atx/gps-freq-counter/README.md

# gps-freq-counter
Frequency counter using a GPS receiver PPS output as its reference

schema
