atx/gps-freq-counter/mech/box.stl

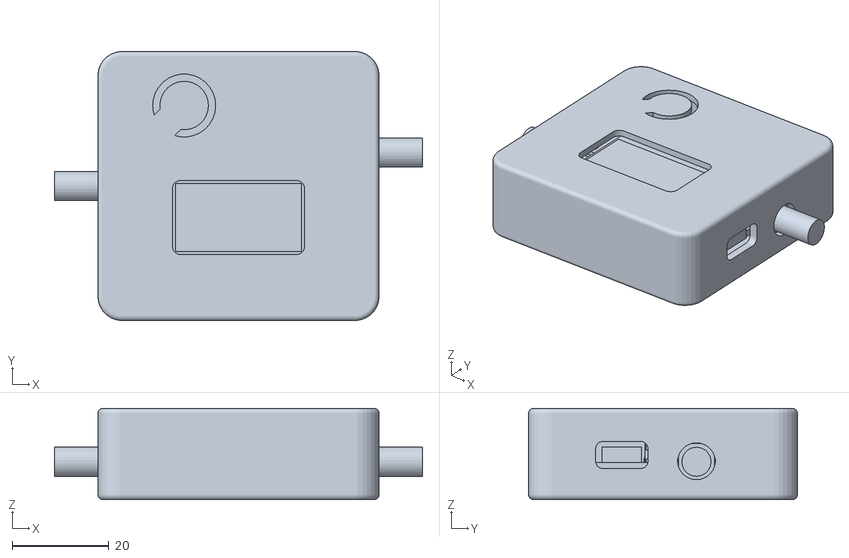
[picture p1: CAD file, 2018-04-28]
mech/box.stl
75.9 x 55.4 x 18.8
