atx/gps-freq-counter/(threads)

Thread 1 (2018-07-31):

Wishlist for v1.1

atx, 2018-07-31:
* [ ] Easier to solder ESD protection for the USB port
 * [ ] Proper test points
 * [ ] Better input processing for weak inputs (comparator?)
 * [ ] More capacitors for the FPGA
 * [ ] Correct footprint for the oscillator
 * [ ] Maybe switch to LEA-6T or NEO-8M?
