atx/gps-freq-counter/pcb/gfc.kicad_pcb

## KiCad design pcb/gfc.kicad_pcb (2018-03-02)

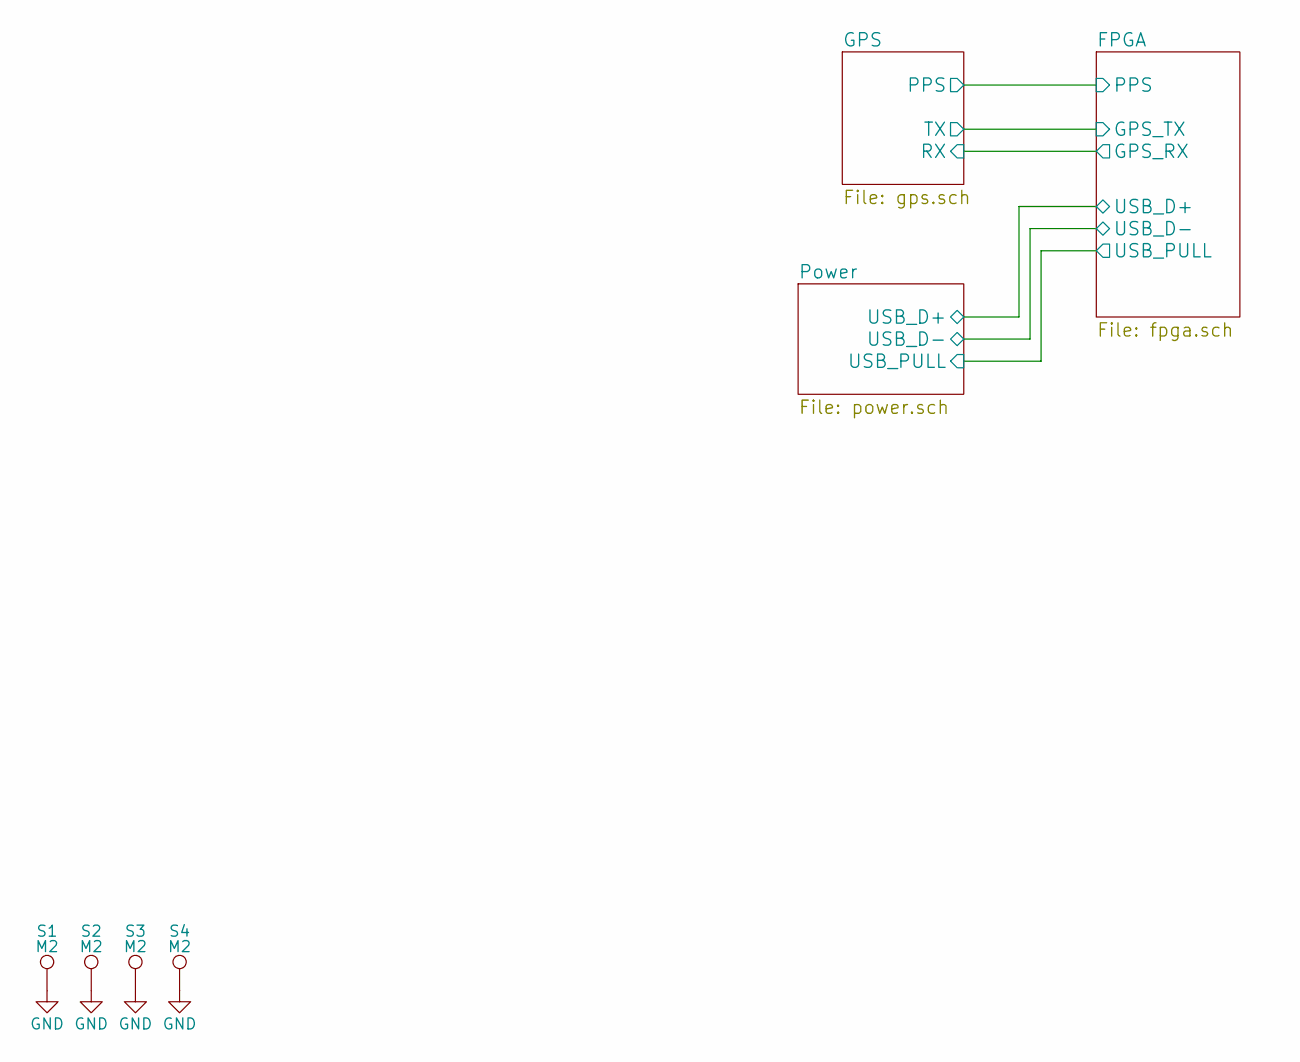
[picture p2: schematic gfc.sch]

Parts:
S1, S2, S3, S4: M2; MountingHole_2.2mm_M2_Pad

Connections:
GND: S1.1, S2.1, S3.1, S4.1; also elsewhere on the board

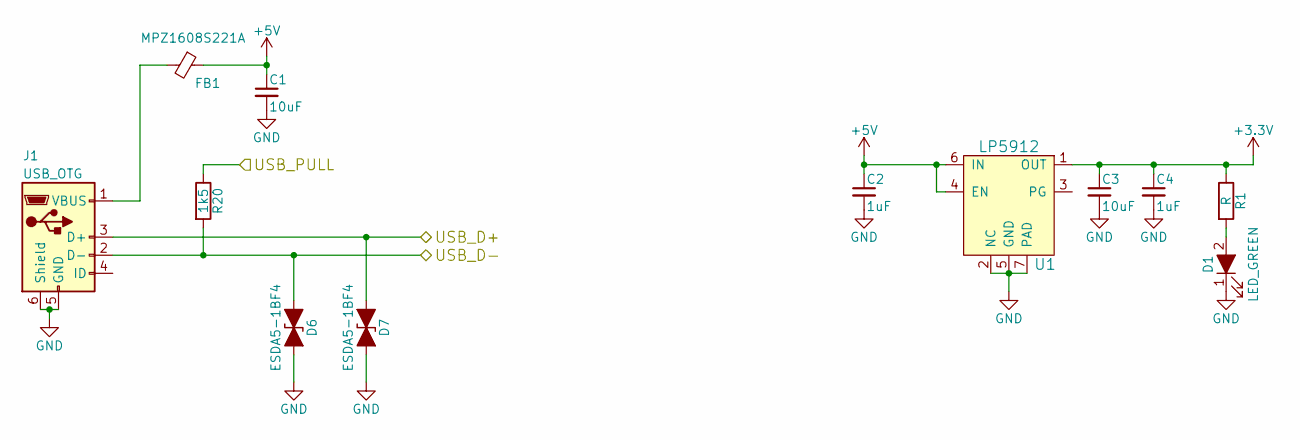
[picture p3: schematic power.sch]

Parts:
C1, C3: 10uF; C_0603
C2, C4: 1uF; C_0402
D1: LED_GREEN; LED_0603
D6, D7: ESDA5-1BF4; D_0603
FB1: MPZ1608S221A; L_0603
J1: USB_OTG; USB_Micro-B
R1: R; R_0402
R20: 1k5; R_0402
U1: LP5912; WSON-6-DRV

Connections:
+3V3: C3.1, C4.1, R1.1, U1.1 (OUT); also elsewhere on the board
+5V: C1.1, C2.1, FB1.1, U1.4 (EN), U1.6 (IN)
/FPGA/USB_D+: D7.1 (A1), J1.3 (D+); also elsewhere on the board
/FPGA/USB_D-: D6.1 (A1), J1.2 (D-), R20.2; also elsewhere on the board
/FPGA/USB_PULL: R20.1; also elsewhere on the board
GND: C1.2, C2.2, C3.2, C4.2, D1.1 (K), D6.2 (A2), D7.2 (A2), J1.5 (GND), J1.6 (Shield), U1.2 (NC), U1.5 (GND), U1.7 (PAD); also elsewhere on the board
unnamed: D1.2 (A), R1.2
unnamed: FB1.2, J1.1 (VBUS)

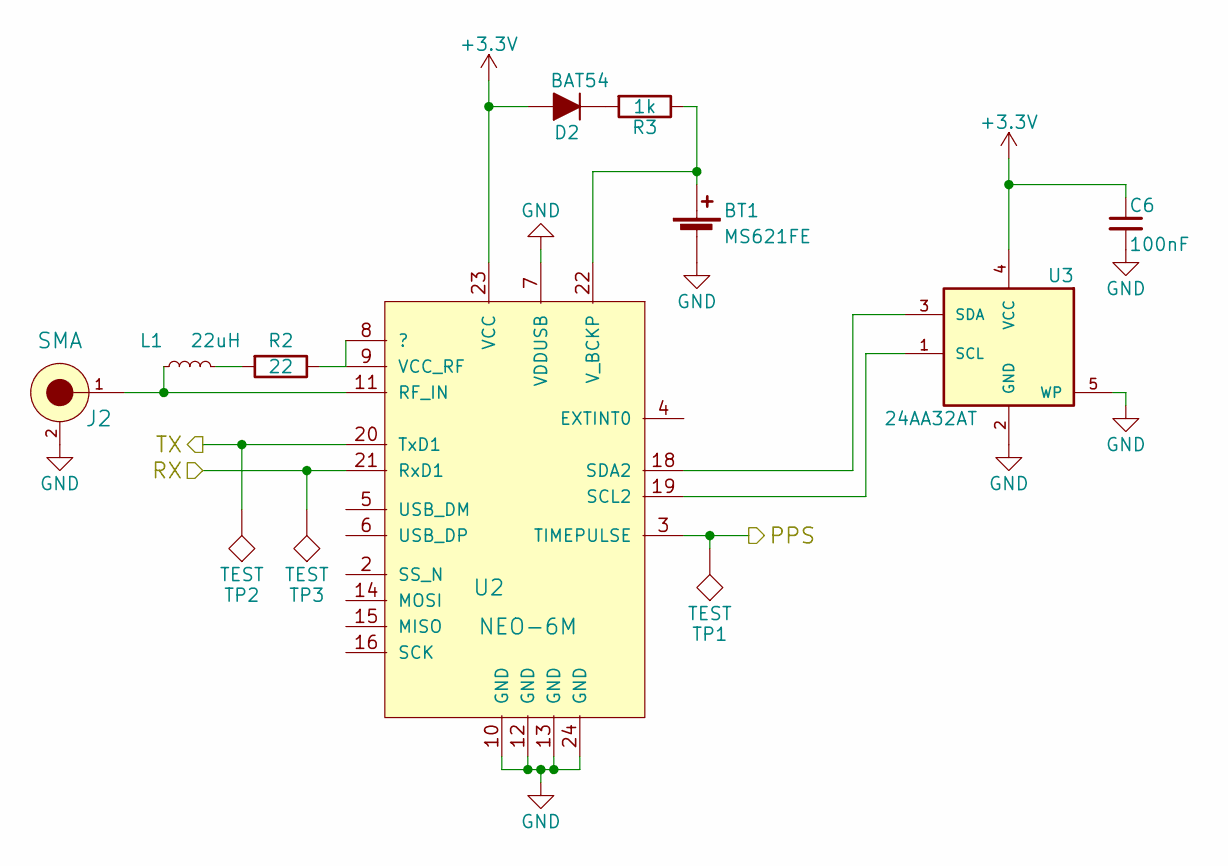
[picture p4: schematic gps.sch]

Parts:
BT1: MS621FE
C6: 100nF; C_0402
D2: BAT54; D_SOT-23_ANK
J2: SMA; CON-SMA-EDGE
L1: 22uH; L_0805
R2: 22; R_0402
R3: 1k; R_0402
TP1, TP2, TP3: TEST; PINTST
U2: NEO-6M; NEO-6
U3: 24AA32AT; SOT-23-5

Connections:
+3V3: C6.1, D2.2 (A), U2.23 (VCC), U3.4 (VCC); also elsewhere on the board
/FPGA/GPS_RX: TP3.1, U2.21 (RxD1); also elsewhere on the board
/FPGA/GPS_TX: TP2.1, U2.20 (TxD1); also elsewhere on the board
/FPGA/PPS: TP1.1, U2.3 (TIMEPULSE); also elsewhere on the board
GND: BT1.2 (-), C6.2, J2.2, J2.3, J2.4, J2.5, U2.7 (VDDUSB), U2.10 (GND), U2.12 (GND), U2.13 (GND), U2.24 (GND), U3.2 (GND), U3.5 (WP); also elsewhere on the board
unnamed: BT1.1 (+), R3.1, U2.22 (V_BCKP)
unnamed: D2.1 (K), R3.2
unnamed: J2.1, L1.1, U2.11 (RF_IN)
unnamed: L1.2, R2.2
unnamed: R2.1, U2.8 (?), U2.9 (VCC_RF)
unnamed: U2.18 (SDA2), U3.3 (SDA)
unnamed: U2.19 (SCL2), U3.1 (SCL)

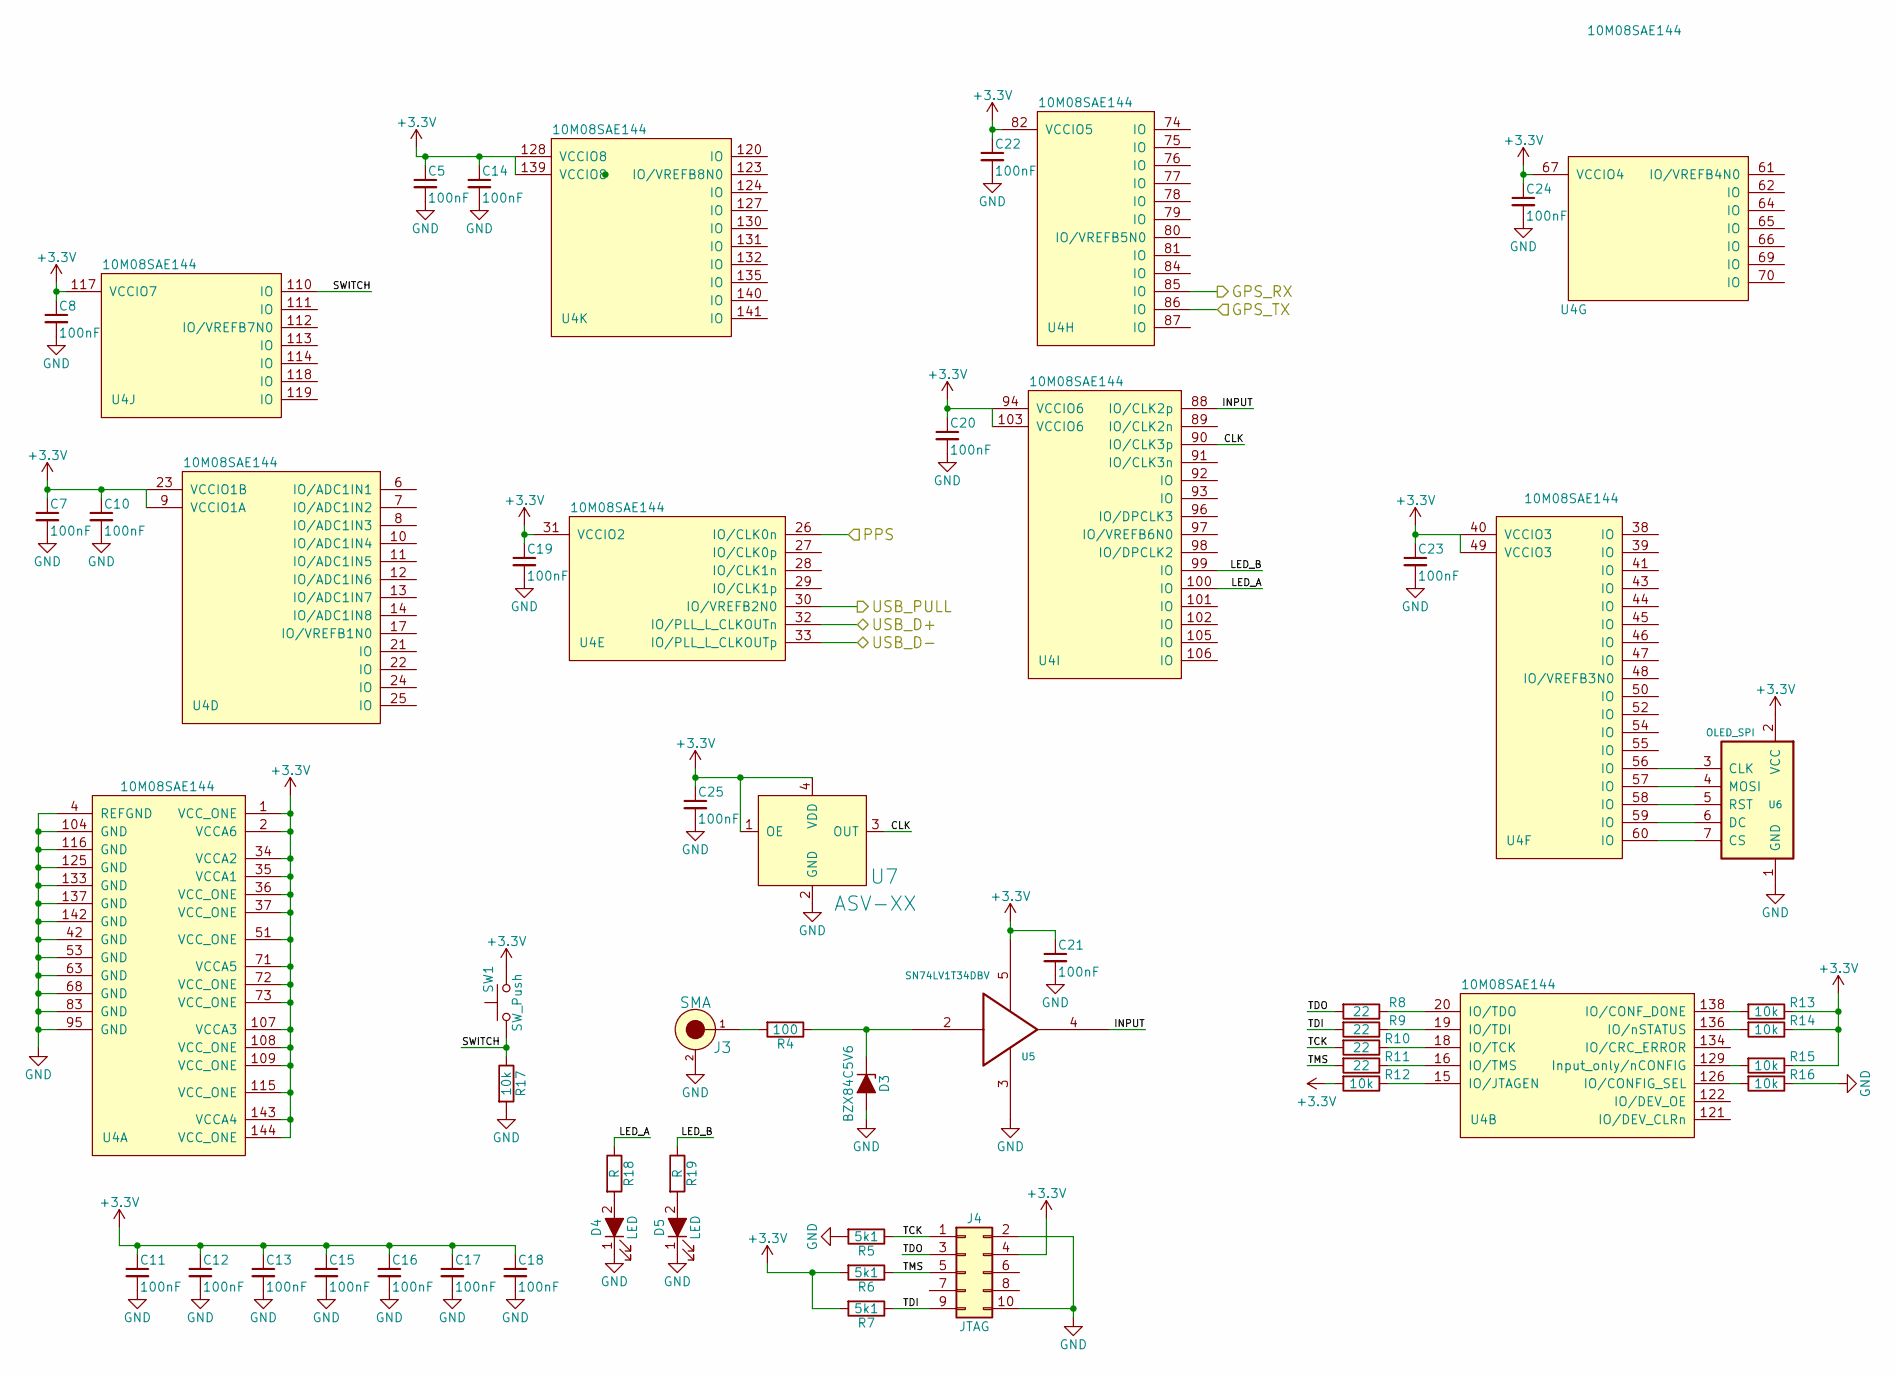
[picture p5: schematic fpga.sch]

Parts:
C5, C7, C8, C10, C11, C12, C13, C14, C15, C16, C17, C18, C19, C20, C21, C22, C23, C24, C25: 100nF; C_0402
D3: BZX84C5V6; D_SOT-23_ANK
D4, D5: LED; LED_0603
J3: SMA; CON-SMA-EDGE
J4: JTAG; Pin_Header_Straight_2x05_Pitch2.54mm_SMD
R4: 100; R_0402
R5, R6, R7: 5k1; R_0402
R8, R9, R10, R11: 22; R_0402
R12, R13, R14, R15, R16, R17: 10k; R_0402
R18, R19: R; R_0402
SW1: SW_Push; SW_PUSH_6mm_h13mm
U4: 10M08SAE144; TQFP-144_20x20mm_Pitch0.5mm
U5: SN74LV1T34DBV; SOT-23-5
U6: OLED_SPI
U7: ASV-XX

Connections:
+3V3: C5.1, C7.1, C8.1, C10.1, C11.1, C12.1, C13.1, C14.1, C15.1, C16.1, C17.1, C18.1, C19.1, C20.1, C21.1, C22.1, C23.1, C24.1, C25.1, J4.4, R6.2, R7.2, R12.2, R13.1, R14.1, R15.1, SW1.2, U4.1 (VCC_ONE), U4.2 (VCCA6), U4.9 (VCCIO1A), U4.23 (VCCIO1B), U4.31 (VCCIO2), U4.34 (VCCA2), U4.35 (VCCA1), U4.36 (VCC_ONE), U4.37 (VCC_ONE), U4.40 (VCCIO3), U4.49 (VCCIO3), U4.51 (VCC_ONE), U4.67 (VCCIO4), U4.71 (VCCA5), U4.72 (VCC_ONE), U4.73 (VCC_ONE), U4.82 (VCCIO5), U4.94 (VCCIO6), U4.103 (VCCIO6), U4.107 (VCCA3), U4.108 (VCC_ONE), U4.109 (VCC_ONE), U4.115 (VCC_ONE), U4.117 (VCCIO7), U4.128 (VCCIO8), U4.139 (VCCIO8), U4.143 (VCCA4), U4.144 (VCC_ONE), U5.5, U6.2 (VCC), U7.1 (OE), U7.4 (VDD); also elsewhere on the board
/FPGA/CLK: U4.90 (IO/CLK3p), U7.3 (OUT)
/FPGA/GPS_RX: U4.85 (IO); also elsewhere on the board
/FPGA/GPS_TX: U4.86 (IO); also elsewhere on the board
/FPGA/INPUT: U4.88 (IO/CLK2p), U5.4
/FPGA/LED_A: R18.1, U4.100 (IO)
/FPGA/LED_B: R19.1, U4.99 (IO)
/FPGA/PPS: U4.26 (IO/CLK0n); also elsewhere on the board
/FPGA/SWITCH: R17.1, SW1.1, U4.110 (IO)
/FPGA/TCK: J4.1, R5.1, R10.2
/FPGA/TDI: J4.9, R7.1, R9.2
/FPGA/TDO: J4.3, R8.2
/FPGA/TMS: J4.5, R6.1, R11.2
/FPGA/USB_D+: U4.32 (IO/PLL_L_CLKOUTn); also elsewhere on the board
/FPGA/USB_D-: U4.33 (IO/PLL_L_CLKOUTp); also elsewhere on the board
/FPGA/USB_PULL: U4.30 (IO/VREFB2N0); also elsewhere on the board
GND: C5.2, C7.2, C8.2, C10.2, C11.2, C12.2, C13.2, C14.2, C15.2, C16.2, C17.2, C18.2, C19.2, C20.2, C21.2, C22.2, C23.2, C24.2, C25.2, D3.2 (A), D4.1 (K), D5.1 (K), J3.2, J3.3, J3.4, J3.5, J4.2, J4.10, R5.2, R16.1, R17.2, U4.4 (REFGND), U4.42 (GND), U4.53 (GND), U4.63 (GND), U4.68 (GND), U4.83 (GND), U4.95 (GND), U4.104 (GND), U4.116 (GND), U4.125 (GND), U4.133 (GND), U4.137 (GND), U4.142 (GND), U5.3, U6.1 (GND), U7.2 (GND); also elsewhere on the board
unnamed: D3.1 (K), R4.1, U5.2
unnamed: D4.2 (A), R18.2
unnamed: D5.2 (A), R19.2
unnamed: J3.1, R4.2
unnamed: R8.1, U4.20 (IO/TDO)
unnamed: R9.1, U4.19 (IO/TDI)
unnamed: R10.1, U4.18 (IO/TCK)
unnamed: R11.1, U4.16 (IO/TMS)
unnamed: R12.1, U4.15 (IO/JTAGEN)
unnamed: R13.2, U4.138 (IO/CONF_DONE)
unnamed: R14.2, U4.136 (IO/nSTATUS)
unnamed: R15.2, U4.129 (Input_only/nCONFIG)
unnamed: R16.2, U4.126 (IO/CONFIG_SEL)
unnamed: U4.56 (IO), U6.3 (CLK)
unnamed: U4.57 (IO), U6.4 (MOSI)
unnamed: U4.58 (IO), U6.5 (RST)
unnamed: U4.59 (IO), U6.6 (DC)
unnamed: U4.60 (IO), U6.7 (CS)

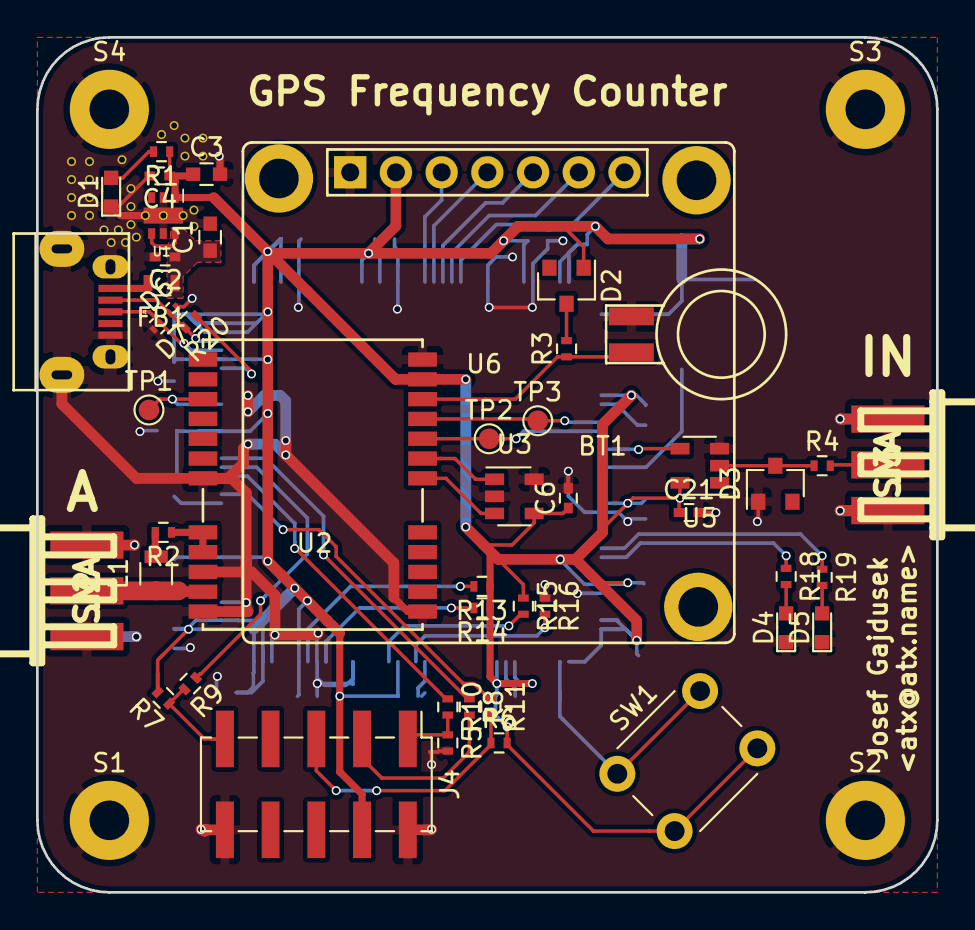
[picture p6: board gfc.kicad_pcb from above]

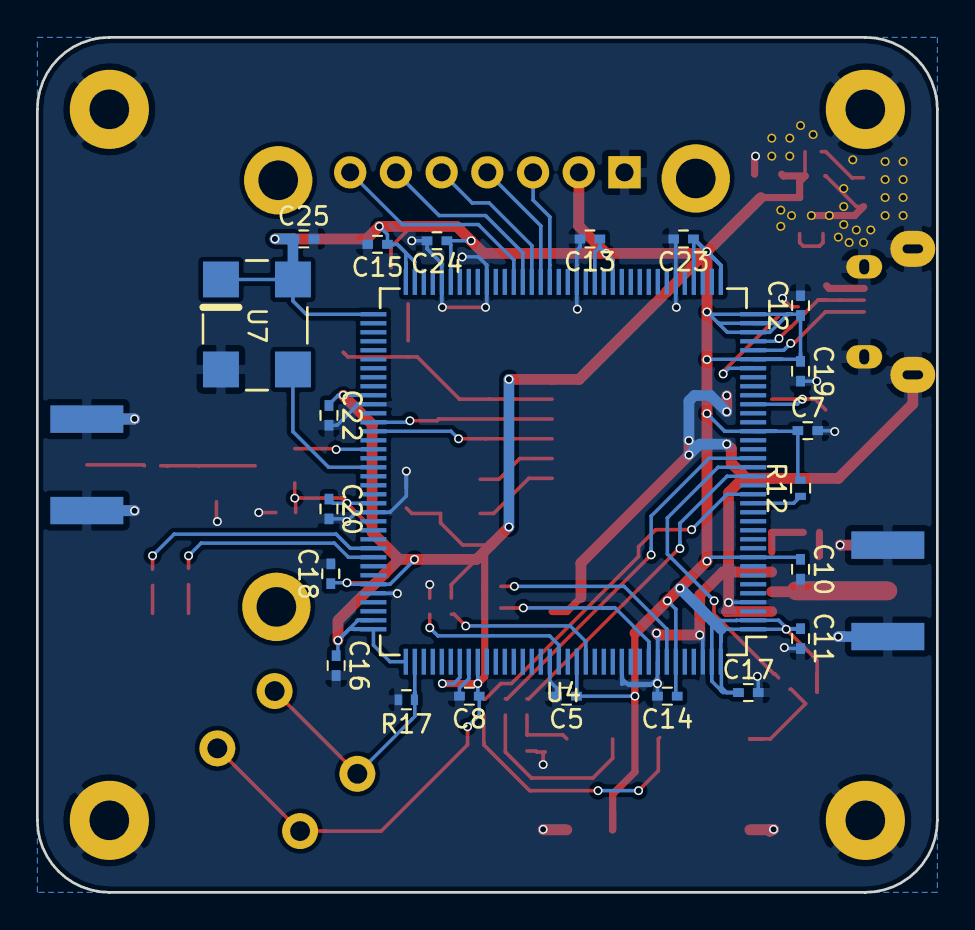
[picture p7: board gfc.kicad_pcb from below]

Board: 2 copper layers, 50.0 x 47.5 mm, 73 parts (22 on the bottom side), 45 nets.
