atx/gps-freq-counter/(commit log)

2018-03-02 pcb: Add the PCB
    [fpga.sch, gfc.kicad_pcb, gfc.sch, gps.sch, power.sch]
2018-03-09 fpga: Add SPI module
2018-03-23 fpga: Improve SPI tests
2018-03-23 fpga/src: Add SPI integration test
2018-03-24 fpga: Add UART transceiver implementation
2018-03-29 fpga: Group SPI signals in SPIBundle
2018-03-29 fpga: PicoRVTests: Switch to the Verilog-based memory implementation
2018-03-29 fpga: SPI: Tie the CS pin to the SPI peripheral
2018-03-31 fpga: Fix the PLL
    Turns out that 100nF for each pin group isn't really sufficient decoupling
2018-03-31 fpga: MemoryMux: Switch to Mux1H
    This is unsurprisingly much faster and smaller
2018-04-01 fpga: Add millisecond timer register
2018-04-01 fpga: SPI: Allow only single ported reads
2018-04-01 fpga: SPI: Fix write not being performed in some circumstances
2018-04-01 fpga: UART: Externalize the status flags
2018-04-08 mech: First version of the enclosure
    To be printed
    [box.scad, box.stl]
2018-04-12 fpga: Switch to using MIF files for the Quartus toolchain
    Faster firmware reloading this way
2018-04-12 fpga: UARTTests: Minor improvement
2018-04-12 Switch to the UBX binary protocol for the GPS module
2018-04-28 mech: Box update
    [box.scad, box.stl]
2018-04-28 src: Flip submenu button order
    [ui.c]
2018-04-28 ui: main: Signal activity with LED A
2018-05-03 src: Signal ublox state activity with the second LED
2018-05-03 src: Switch to a time-specific type
2018-05-03 src: Show difference from a guessed "ideal" oscillator frequency
    [ui.c, utils.h]
2018-05-05 schema: Add a block schematic
2018-06-30 src: bintoverilog: Handle correctly odd-sized files
    [bintoverilog.py]
2018-06-30 src: usb: Fix wTotalLength in the configuration descriptor
    Oops, lsusb really dislikes that zero
    [usb.c]
2018-07-01 src: Add command to fetch current measurement data
2018-07-06 src: Fix ui_on_pps getting called without the argument
    [main.c, ui.c]
2018-07-13 fpga: tests: Switch from BusTester to BusHelper
2018-07-13 pcb: Add a lingering file
    Looks like eeschema -> pcbnew file (?)
2018-07-15 src: main: Don't blink the LED for status handlers
    These are getting called all the time, which made the LED useless as
    an indicator of activity.
